Mogreach/SNN_FF-STDP_v1/Gen_out/Saif/README.md

# SAIF 活动文件

保存仿真导出的 Switching Activity Interchange Format 文件，用于 Vivado `report_power` 的动态功耗估计。

- 历史 SAIF 文件：仅用于保留旧功耗分析记录，不用于当前 7010 结果。
- `dut_P8.saif`：并行度配置相关的活动文件。

SAIF 仅在层次路径、顶层、时钟和参数与当前综合网表匹配时有意义。重新跑仿真后，使用 `user/script/gen_saif.tcl` 的层次映射方式重新导入，不应把历史结果当作当前功耗结论。
