Mogreach/SNN_FF-STDP_v1/assets/README.md

# 文档资源

文档图片按文档名称分目录保存。当前全部设计附件位于 `FF-STDP加速器设计（ZYNQ）/`，主文档通过仓库相对路径引用，移动或重命名图片后需同步检查 Markdown 链接。
