Mogreach/SNN_FF-STDP_v1/assets/FF-STDP加速器设计（ZYNQ）/README.md

# FF-STDP 加速器设计图片

本目录统一保存 `FF-STDP加速器设计（ZYNQ）.md` 的历史结构图、Vivado 截图、波形、ILA 截图和时序分析图片。`image N.png` 为旧文档附件名，`Pasted_*.png` 为后续补充图片；为保证引用和历史可追溯性，归档时未批量改名。

新增图片时请继续使用主文档相对路径 `assets/FF-STDP加速器设计（ZYNQ）/<文件名>`，不要引用工作站绝对路径。
