Mogreach/SNN_FF-STDP_v1/user/script/brian2_sim/README.md

# brian2_sim

Brian2 参考模型/验证脚本的预留目录，当前归档没有脚本。现有脉冲编码调用位于 `hardware_sim/gen_data_flow.py`，并依赖仓库外部的 `SNN-forwardforward` 工程。
