Mogreach/SNN_FF-STDP_v1/user/src/snn_ff/synaptic_core/README.md

# 突触与 FF-STDP 更新

- `synaptic_core.v`：读取并行突触权重，形成送往神经元核心的加权输入，并协调训练写回。权重存储由 `SNN_RAM_SIM` 宏二选一：仿真用行为模型，FPGA 用 `sram_synaptic` BRAM IP，详见 `../sram/README.md`。
- `ffstdp_update.v`：根据正/负样本、前后脉冲计数和梯度 ROM 输出计算权重增量，执行定点加法/饱和后写回突触 SRAM。

量化尺度由软件生成脚本中的 `WEIGHT_MAX / 2^(WEIGHT_WIDTH-1)` 决定。修改学习率、权重范围或位宽时，必须联合验证 ROM 数值、补码解释、加法位宽、饱和规则以及权重文件打包顺序。
