Mogreach/SNN_FF-STDP_v1/user/src/snn_ff/aer_out/README.md

# AER 输出

- `aer_out.v`：单路输出事件缓存/握手控制。
- `aer_outs.v`：按并行神经元组织多个输出并汇聚。
- `adder_tree.v`：对并行神经元相关量做树形求和。

该路径把神经元核心产生的脉冲事件编码为 AER 输出，并与下层输入或顶层终端 ack 完成四相握手。修改输出神经元数或并行度时需同步检查 AER 地址宽度 `2+$clog2(OUTPUT_NEURON)`。
