Mogreach/SNN_FF-STDP_v1/assets/FF-STDP加速器设计（ZYNQ）/image 18.png

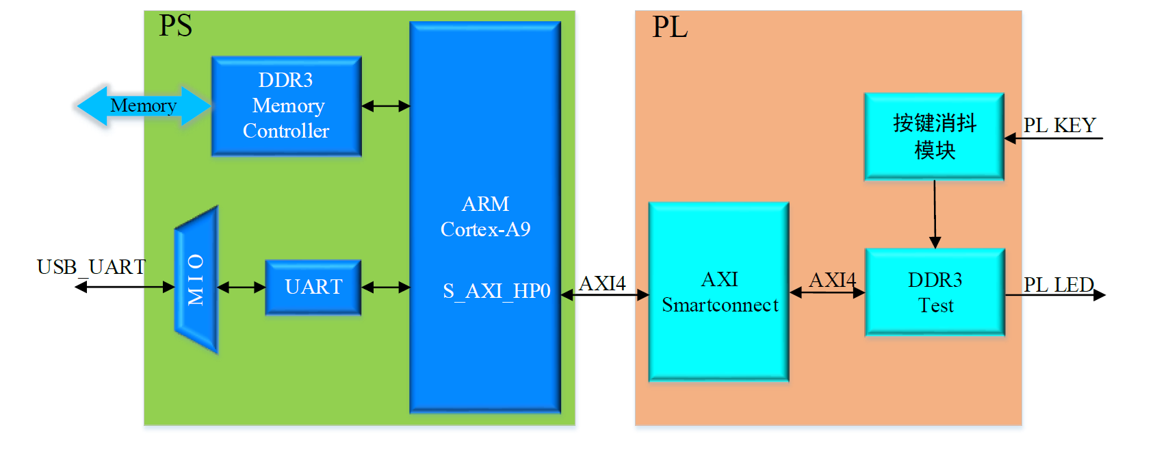
assets/FF-STDP加速器设计（ZYNQ）/image 18.png
