Mogreach/SNN_FF-STDP_v1/assets/FF-STDP加速器设计（ZYNQ）/image.png

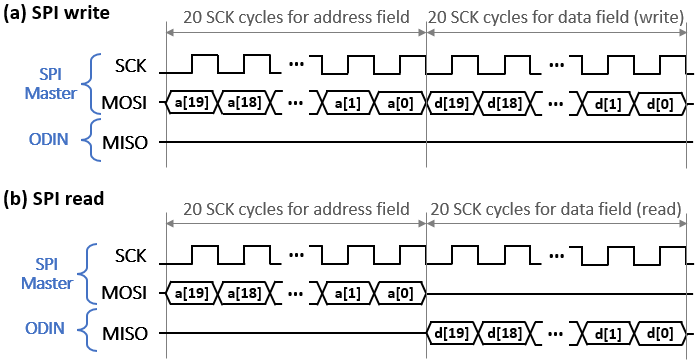
assets/FF-STDP加速器设计（ZYNQ）/image.png
