Mogreach/SNN_FF-STDP_v1/assets/FF-STDP加速器设计（ZYNQ）/Pasted_20260914115012_FF-STDP加速器设计（ZYNQ）.png

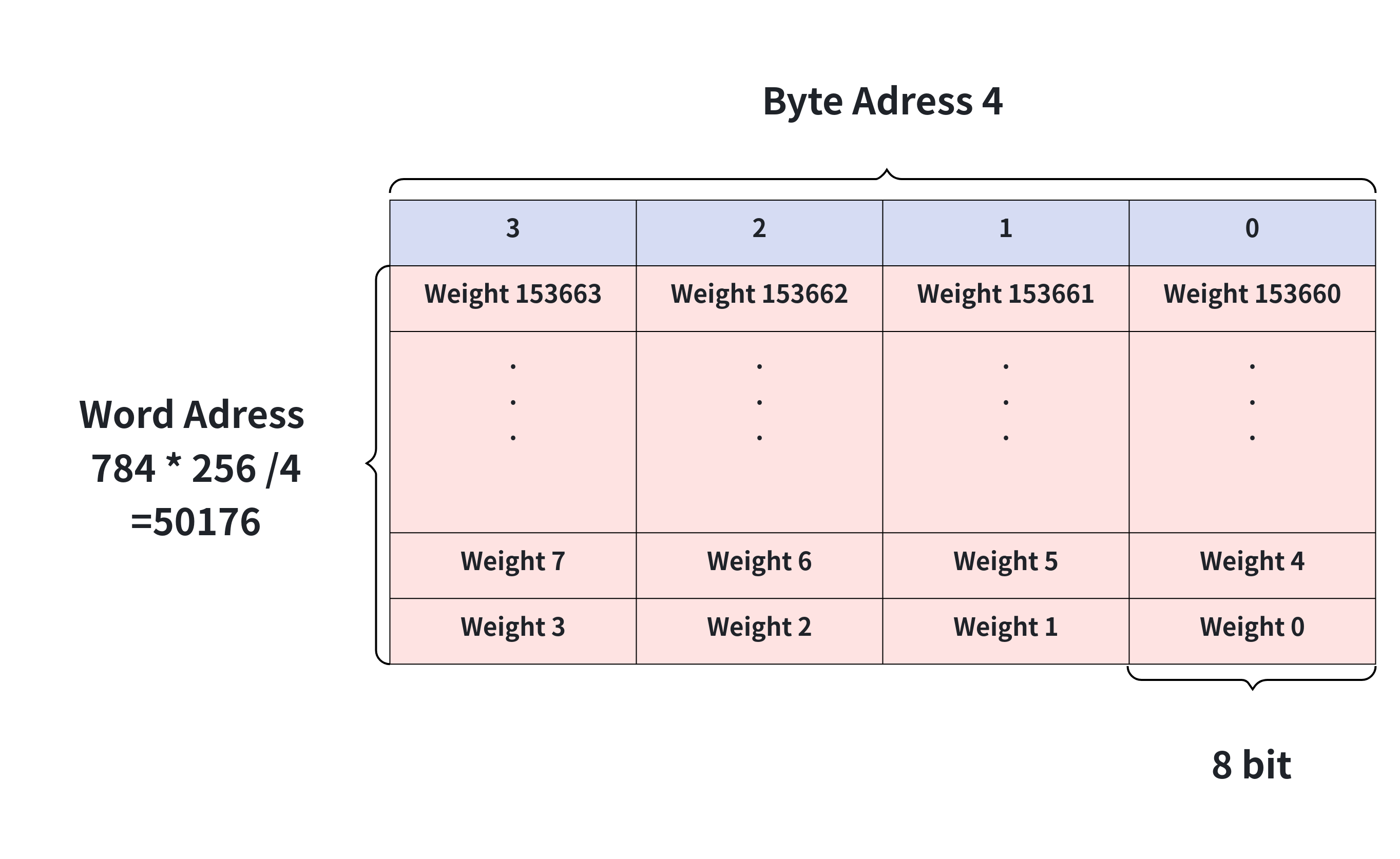
assets/FF-STDP加速器设计（ZYNQ）/Pasted_20260914115012_FF-STDP加速器设计（ZYNQ）.png
