Mogreach/SNN_FF-STDP_v1/user/sim/iverilog/build_axi_test/README.md

# Icarus 构建产物

保存 Icarus Verilog 编译输出、日志和波形。当前 AXI+SNN 回归生成 `tb_axi4_rw_test_v1_0_M_AXI.vvp/.vcd/.log`；这些文件均被 Git 忽略。源文件清单位于上一级 `axi_snn_filelist.f`。
