Mogreach/SNN_FF-STDP_v1/user/data/axi4_ddr_rw.xdc

set_property IOSTANDARD LVCMOS33 [get_ports key_init]
set_property IOSTANDARD LVCMOS33 [get_ports key_train_enable]
set_property IOSTANDARD LVCMOS33 [get_ports train_enable_flag]
set_property IOSTANDARD LVCMOS33 [get_ports train_finish_flag]

set_property PACKAGE_PIN L14 [get_ports key_init]
set_property PACKAGE_PIN K16 [get_ports key_train_enable]
set_property PACKAGE_PIN H15 [get_ports train_enable_flag]
set_property PACKAGE_PIN L15 [get_ports train_finish_flag]
