Mogreach/SNN_FF-STDP_v1/user/src/snn_ff/aer_out/aer_outs.v

// Copyright (C) 2019-2022, Université catholique de Louvain (UCLouvain, Belgium), University of Zürich (UZH, Switzerland),
//         Katholieke Universiteit Leuven (KU Leuven, Belgium), and Delft University of Technology (TU Delft, Netherlands).
// SPDX-License-Identifier: Apache-2.0 WITH SHL-2.1
//
// Licensed under the Solderpad Hardware License v 2.1 (the “License”); you may not use this file except in compliance
// with the License, or, at your option, the Apache License version 2.0. You may obtain a copy of the License at
// https://solderpad.org/licenses/SHL-2.1/
//
// Unless required by applicable law or agreed to in writing, any work distributed under the License is distributed on
// an “AS IS” BASIS, WITHOUT WARRANTIES OR CONDITIONS OF ANY KIND, either express or implied. See the License for the
// specific language governing permissions and limitations under the License.
//
//------------------------------------------------------------------------------
//
// "aer_out.v" - Output AER module, custom monitoring mode from ODIN was removed
// 
// Project: tinyODIN - A low-cost digital spiking neuromorphic processor adapted from ODIN.
//
// Author:  C. Frenkel, Delft University of Technology
//
// Cite/paper: C. Frenkel, M. Lefebvre, J.-D. Legat and D. Bol, "A 0.086-mm² 12.7-pJ/SOP 64k-Synapse 256-Neuron Online-Learning
//             Digital Spiking Neuromorphic Processor in 28-nm CMOS," IEEE Transactions on Biomedical Circuits and Systems,
//             vol. 13, no. 1, pp. 145-158, 2019.
//
//------------------------------------------------------------------------------


module aer_outs #(
    parameter TIME_STEP = 8,
    parameter INPUT_NEURON = 784,
    parameter OUTPUT_NEURON = 256,
    parameter AER_WIDTH = 12,

    parameter PRE_NEUR_ADDR_WIDTH = 10,
    parameter PRE_NEUR_WORD_ADDR_WIDTH= 10,
    parameter PRE_NEUR_BYTE_ADDR_WIDTH = 0,

    parameter POST_NEUR_ADDR_WIDTH = 10,
    parameter POST_NEUR_WORD_ADDR_WIDTH= 8,
    parameter POST_NEUR_BYTE_ADDR_WIDTH = 2,
    parameter POST_NEUR_PARALLEL = 4,
    
    parameter PRE_NEUR_DATA_WIDTH = 8,
    parameter POST_NEUR_DATA_WIDTH = 32,
    parameter POST_NEUR_MEM_WIDTH = 12,
    parameter POST_NEUR_SPIKE_CNT_WIDTH = 7,
    parameter SYN_ARRAY_DATA_WIDTH = 32,
    parameter SYN_ARRAY_ADDR_WIDTH = 16,
    parameter WEIGHT_WIDTH = 8
)(

    // Global input ----------------------------------- 
    input  wire           CLK,
    input  wire           RST,
    // Neuron data inputs -----------------------------
    input  wire [POST_NEUR_PARALLEL-1:0]     NEUR_EVENT_OUT,
    // Input from scheduler ---------------------------
    input  wire [AER_WIDTH-1:0] SCHED_DATA_OUT,
    // Input from controller --------------------------
    input  wire           CTRL_TREF_EVENT,
    input  wire           CTRL_POST_NEUR_CS, 
    input  wire           CTRL_POST_NEUR_WE, 
    input  wire           CTRL_AEROUT_PUSH_NEUR,
    input  wire           CTRL_AEROUT_POP_NEUR,
    input  wire           CTRL_AEROUT_POP_TSTEP,
    input  wire [POST_NEUR_ADDR_WIDTH-1:0]     CTRL_POST_NEURON_ADDRESS,
    input  wire           CTRL_AEROUT_TREF_FINISH,
    // Inputs from neurons ------------------------------------
    input wire [POST_NEUR_SPIKE_CNT_WIDTH * POST_NEUR_PARALLEL -1 :0] POST_NEUR_S_CNT,
    
    // Output to controller ---------------------------
    output wire           AEROUT_CTRL_FINISH,
    
	// Output 8-bit AER link --------------------------
	output reg  [  AER_WIDTH-1:0] AEROUT_ADDR, 
	output reg  	      AEROUT_REQ,
	input  wire 	      AEROUT_ACK,

    output reg [31:0]     GOODNESS,
    output wire           ONE_SAMPLE_FINISH
);
    localparam T_LOG2 = $clog2(TIME_STEP);
    reg                                 AEROUT_ACK_sync_int,      AEROUT_ACK_sync,AEROUT_ACK_sync_del;
    reg                                 aer_out_addr_last,        aer_out_addr_last_int;
    reg                                 aer_out_trans               ;//AEROUT输出事件中
    reg                                 fifo_rd_en_int              ;
    reg                                 goodness_en_d0              ;
    reg                                 goodness_en_d1              ;
    reg                [   5: 0]        ctrl_tref_finish_delay      ;

    wire                                aer_out_start               ;
    wire                                AEROUT_ACK_sync_negedge     ;
    wire                                aer_out_addr_last_negedge   ;
    wire                                rst_activity                ;
    wire                                fifo_rd_en                  ;
    wire                                fifo_wr_en                  ;
    wire                                fifo_empty                  ;
    wire                                fifo_full                   ;
    wire                                goodness_en                 ;
    wire                                ctrl_tref_finish_delay_posedge  ;
    
    
    
    wire               [POST_NEUR_PARALLEL*AER_WIDTH-1: 0]                  aer_out_fifo_din                 ;
    wire               [AER_WIDTH-1: 0]                                     aer_out_fifo_dout                ;
    wire               [    T_LOG2: 0]                                      post_neur_cnt[0:POST_NEUR_PARALLEL-1];
    reg                [2*(T_LOG2+1)-1: 0]                                  post_neur_goodness[0:POST_NEUR_PARALLEL-1];
    wire               [(2*(T_LOG2+1)*POST_NEUR_PARALLEL)-1: 0]             post_neur_goodness_bus;
    wire [2*(T_LOG2+1)+$clog2(POST_NEUR_PARALLEL)-1:0] post_neur_goodness_sum;

    assign                              rst_activity                = RST;
    // AER空闲，fifo不空，且此时fifo_out不是无效事件
    assign                              fifo_rd_en                  = CTRL_AEROUT_POP_NEUR & !AEROUT_REQ & !AEROUT_ACK_sync & !fifo_empty & !aer_out_start;
    assign                              fifo_wr_en                  = CTRL_AEROUT_PUSH_NEUR & !fifo_full;

    assign                              AEROUT_ACK_sync_negedge     = !AEROUT_ACK_sync & AEROUT_ACK_sync_del;
    assign                              aer_out_addr_last_negedge   = !aer_out_addr_last & aer_out_addr_last_int;

    assign                              aer_out_start               = fifo_rd_en_int && (!(&aer_out_fifo_dout[11:10]));// 无效事件11则不传输
    assign                              AEROUT_CTRL_FINISH          = aer_out_addr_last_negedge;

    assign                              ctrl_tref_finish_delay_posedge= !ctrl_tref_finish_delay[5] && ctrl_tref_finish_delay[4];
    assign                              ONE_SAMPLE_FINISH           = ctrl_tref_finish_delay_posedge;
    assign                              goodness_en                 = CTRL_POST_NEUR_WE && CTRL_TREF_EVENT;
    

    genvar i;
    generate
        for (i = 0; i<POST_NEUR_PARALLEL; i=i+1) begin : gen_aer_output_lane
            localparam [POST_NEUR_ADDR_WIDTH-1:0] LANE_OFFSET = i;
            wire [POST_NEUR_ADDR_WIDTH-1:0] lane_neuron_addr;
            assign lane_neuron_addr = CTRL_POST_NEURON_ADDRESS + LANE_OFFSET;
            assign post_neur_cnt[i] = POST_NEUR_S_CNT[i*POST_NEUR_SPIKE_CNT_WIDTH +: T_LOG2+1];
            assign aer_out_fifo_din[AER_WIDTH*(POST_NEUR_PARALLEL-i)-1 -: AER_WIDTH] =
                NEUR_EVENT_OUT[i] ? {2'b00, lane_neuron_addr} : {2'b11, 10'd0};
            // goodness_mult goodness_square (
            // .CLK                                (CLK                       ),// input wire CLK
            // .A                                  (post_neur_cnt[i]          ),// input wire [4 : 0] A
            // .B                                  (post_neur_cnt[i]          ),// input wire [4 : 0] B
            // .P                                  (post_neur_goodness[i]     ) // output wire [9 : 0] P
            //         );
            always @(posedge CLK)           
            begin                                        
                post_neur_goodness[i] <= post_neur_cnt[i] * post_neur_cnt[i];              
            end

            assign post_neur_goodness_bus[i*(2*(T_LOG2+1))+:2*(T_LOG2+1)] = post_neur_goodness[i];
        end
    endgenerate


    adder_tree #(
        .N(POST_NEUR_PARALLEL),
        .WIDTH(2*(T_LOG2+1))
    ) adder_tree_goodness (
        .in(post_neur_goodness_bus),
        .out(post_neur_goodness_sum)
    );

    always @(posedge CLK or posedge rst_activity)           
        begin                                        
            if(rst_activity || ctrl_tref_finish_delay_posedge)                               
                GOODNESS <= 'd0;                         
            else if(goodness_en_d1)                                
                GOODNESS <= GOODNESS + post_neur_goodness_sum;              
            else   
                GOODNESS <= GOODNESS;                                  
        end                                          


    // Sync barrier
    always @(posedge CLK, posedge rst_activity) begin
        if (rst_activity) begin
            AEROUT_ACK_sync_int <= 1'b0;
            AEROUT_ACK_sync	    <= 1'b0;
            AEROUT_ACK_sync_del <= 1'b0;
            aer_out_addr_last_int <= 1'b0;
            fifo_rd_en_int <= 1'b0;
            goodness_en_d0 <= 1'b0;
            goodness_en_d1 <= 1'b0;
            ctrl_tref_finish_delay <= 6'b0;
        end
        else begin
            AEROUT_ACK_sync_int <= AEROUT_ACK;
            AEROUT_ACK_sync	    <= AEROUT_ACK_sync_int;
            AEROUT_ACK_sync_del <= AEROUT_ACK_sync;
            aer_out_addr_last_int <= aer_out_addr_last;
            fifo_rd_en_int <= fifo_rd_en;
            goodness_en_d0 <= goodness_en;
            goodness_en_d1 <= goodness_en_d0;
            ctrl_tref_finish_delay <= {ctrl_tref_finish_delay[4:0],CTRL_AEROUT_TREF_FINISH};
        end
    end

                                                                            
    // Output AER interface
    always @(posedge CLK, posedge rst_activity) begin
        if (rst_activity) begin
            AEROUT_ADDR             <= 10'b0;
            AEROUT_REQ              <= 1'b0;
            aer_out_trans           <= 1'b0;
            aer_out_addr_last       <= 1'b0;
        end else begin
            // 只有当处于POP_TSTEP，且fifo已排空，且aerout不在传输中，且还没发送tstep_event，才开始发送tstep_event
            if (CTRL_AEROUT_POP_TSTEP && fifo_empty && !aer_out_trans && !AEROUT_CTRL_FINISH)begin
                AEROUT_ADDR      <= {2'b01,10'd0};
                AEROUT_REQ       <= 1'b1;
                aer_out_trans    <= 1'b1;
                aer_out_addr_last <= 1'b1;
            end else if ((aer_out_start) && !AEROUT_ACK_sync) begin
                AEROUT_ADDR      <= aer_out_fifo_dout;
                AEROUT_REQ       <= 1'b1;
                aer_out_trans <= 1'b1;
                aer_out_addr_last <= 1'b0;
            end else if (AEROUT_ACK_sync) begin
                AEROUT_REQ       <= 1'b0;
                aer_out_trans <= 1'b1;
                aer_out_addr_last <= aer_out_addr_last;
            end else if (AEROUT_ACK_sync_negedge) begin
                AEROUT_REQ       <= 1'b0;
                aer_out_trans <= 1'b0;
                aer_out_addr_last <= 1'b0;
            end
        end
    end
    
    // aer_out_fifo aer_out_fifo_0 (
    // .clk(CLK),      // input wire clk
    // .srst(rst_activity),    // input wire srst
    // .din(aer_out_fifo_din),      // input wire [47 : 0] din
    // .wr_en(fifo_wr_en),  // input wire wr_en
    // .rd_en(fifo_rd_en),  // input wire rd_en
    // .dout(aer_out_fifo_dout),    // output wire [11 : 0] dout
    // .full(fifo_full),    // output wire full
    // .empty(fifo_empty)  // output wire empty
    // );
    
    syncFIFO_diffWidth #(
    .DIN_WIDTH                             (AER_WIDTH * POST_NEUR_PARALLEL),
    .DOUT_WIDTH                            (AER_WIDTH          ),
    .WADDR_WIDTH                           ($clog2(2*(POST_NEUR_PARALLEL-1))) 
    ) syncFIFO_diffWidth_u0 (
    .din                                   (aer_out_fifo_din   ),
    .wr_en                                 (fifo_wr_en         ),
    .full                                  (fifo_full          ),
    .almost_full                           (                   ),
    .dout                                  (aer_out_fifo_dout  ),
    .rd_en                                 (fifo_rd_en         ),
    .empty                                 (fifo_empty         ),
    .almost_empty                          (                   ),
    .clk                                   (CLK                ),
    .rst                                   (RST                ) 
    );

endmodule 
