Mogreach/SNN_FF-STDP_v1/user/src/snn_ff/sram/sram_synaptic.v

// 仿真用行为模型。FPGA 构建由工程中的 blk_mem_gen IP "sram_synaptic" 提供，
// 二者模块名相同，因此本文件整体只在定义了 SNN_RAM_SIM 时参与编译，
// 避免把整个 user/src 加入 Vivado 时产生重复定义。
`ifdef SNN_RAM_SIM
module sram_synaptic #(
    parameter  ADDR_WIDTH = 8,
    parameter  DATA_WIDTH = 32,
    parameter  SRAM_DEPTH = 256
)

(

    // Global inputs
    input          CK,                       // Clock (synchronous read/write)

    // Control and data inputs
    input          CS,                       // Chip select
    input          WE,                       // Write enable
    input  [ADDR_WIDTH-1:0] A,                        // Address bus 
    input  [DATA_WIDTH-1:0] D,                        // Data input bus (write)

    // Data output
    output [DATA_WIDTH-1:0] Q                         // Data output bus (read)   
);
    /*
     *  Simple behavioral code for simulation, to be replaced by a 256-word 32-bit SRAM macro 
     *  or Block RAM (BRAM) memory with the same format for FPGA implementations.
     */      
        reg [DATA_WIDTH-1:0] SRAM[0:SRAM_DEPTH-1];
        reg [DATA_WIDTH-1:0] Qr;

        always @(posedge CK) begin
            Qr <= CS ? SRAM[A] : Qr;
            if (CS & WE) SRAM[A] <= D;
        end
        assign Q = Qr;


endmodule
`endif
