Mogreach/SNN_FF-STDP_v1/user/src/axi_rw/axi4_rw_test_v1_0_M_AXI.v

`timescale 1 ns / 1 ps

	module axi4_rw_test_v1_0_M_AXI #
	(
		// Users to add parameters here
		parameter TIME_TOTAL_STEP = 8,
		parameter DATA_SIZE = 784,
		parameter TOTAL_TRAIN_SIZE = 2 * 1000, // 训练样本数（含正负样本）
		parameter TOTAL_TEST_SIZE  = 10 * 100, //  测试样本数
		// User parameters ends

		// Do not modify the parameters beyond this line
		// Base address of targeted slave
		parameter  C_M_TARGET_SLAVE_READ_ADDR	= 32'h00200000, // 读基地址
		parameter  C_M_TARGET_SLAVE_WRITE_ADDR  = 32'h01900000, // 写基地址
		// Burst Length. Supports 1, 2, 4, 8, 16, 32, 64, 128, 256 burst lengths
		//每次突发传输的长度（以数据字为单位）。
		parameter integer C_M_AXI_READ_BURST_LEN	= 4,
		parameter integer C_M_AXI_WRITE_BURST_LEN	= 1,
		// Thread ID Width
		parameter integer C_M_AXI_ID_WIDTH	= 1,
		// Width of Address Bus
		parameter integer C_M_AXI_ADDR_WIDTH	= 32,
		// Width of Data Bus
		//数据总线的宽度（以位为单位）。
		parameter integer C_M_AXI_DATA_WIDTH	= 32,
		// Width of User Write Address Bus
		parameter integer C_M_AXI_AWUSER_WIDTH	= 0,
		// Width of User Read Address Bus
		parameter integer C_M_AXI_ARUSER_WIDTH	= 0,
		// Width of User Write Data Bus
		parameter integer C_M_AXI_WUSER_WIDTH	= 0,
		// Width of User Read Data Bus
		parameter integer C_M_AXI_RUSER_WIDTH	= 0,
		// Width of User Response Bus
		parameter integer C_M_AXI_BUSER_WIDTH	= 0
	)
	(
		// Users to add ports here
		// input from SNN Module
		input  wire                         PROCESS_DONE               ,
		input  wire        [  31: 0]        GOODNESS                   ,
		input  wire                         SNN_CLK                    ,
		input  wire                         AER_IN_ACK                 ,
		output wire                         AER_IN_REQ                 ,
		output wire        [  11: 0]        AER_IN_ADDR                ,
    	output reg                          IS_POS                     ,
		output reg   						IS_TRAIN                   ,
		input wire  train_enable_txn,
		// Debug
    	output wire        [   2: 0]        STATE                      ,
		// User ports ends

		// Do not modify the ports beyond this line
		// Initiate AXI transactions
		input wire  INIT_AXI_TXN,
		// Asserts when transaction is complete
		output reg  TRAIN_ENABLE_FLAG,
		// Asserts when ERROR is detected
		output reg  TRAIN_FINISH_FLAG,
		// Global Clock Signal.
		input wire  M_AXI_ACLK,
		// Global Reset Singal. This Signal is Active Low
		input wire  M_AXI_ARESETN,
		// Master Interface Write Address ID
		output wire [C_M_AXI_ID_WIDTH-1 : 0] M_AXI_AWID,
		// Master Interface Write Address
		output wire [C_M_AXI_ADDR_WIDTH-1 : 0] M_AXI_AWADDR,
		// Burst length. The burst length gives the exact number of transfers in a burst
		output wire [7 : 0] M_AXI_AWLEN,
		// Burst size. This signal indicates the size of each transfer in the burst
		output wire [2 : 0] M_AXI_AWSIZE,
		// Burst type. The burst type and the size information, 
    // determine how the address for each transfer within the burst is calculated.
		output wire [1 : 0] M_AXI_AWBURST,
		// Lock type. Provides additional information about the
    // atomic characteristics of the transfer.
		output wire  M_AXI_AWLOCK,
		// Memory type. This signal indicates how transactions
    // are required to progress through a system.
		output wire [3 : 0] M_AXI_AWCACHE,
		// Protection type. This signal indicates the privilege
    // and security level of the transaction, and whether
    // the transaction is a data access or an instruction access.
		output wire [2 : 0] M_AXI_AWPROT,
		// Quality of Service, QoS identifier sent for each write transaction.
		output wire [3 : 0] M_AXI_AWQOS,
		// Optional User-defined signal in the write address channel.
		output wire [C_M_AXI_AWUSER_WIDTH-1 : 0] M_AXI_AWUSER,
		// Write address valid. This signal indicates that
    // the channel is signaling valid write address and control information.
		output wire  M_AXI_AWVALID,
		// Write address ready. This signal indicates that
    // the slave is ready to accept an address and associated control signals
		input wire  M_AXI_AWREADY,
		// Master Interface Write Data.
		output wire [C_M_AXI_DATA_WIDTH-1 : 0] M_AXI_WDATA,
		// Write strobes. This signal indicates which byte
    // lanes hold valid data. There is one write strobe
    // bit for each eight bits of the write data bus.
		output wire [C_M_AXI_DATA_WIDTH/8-1 : 0] M_AXI_WSTRB,
		// Write last. This signal indicates the last transfer in a write burst.
		output wire  M_AXI_WLAST,
		// Optional User-defined signal in the write data channel.
		output wire [C_M_AXI_WUSER_WIDTH-1 : 0] M_AXI_WUSER,
		// Write valid. This signal indicates that valid write
    // data and strobes are available
		output wire  M_AXI_WVALID,
		// Write ready. This signal indicates that the slave
    // can accept the write data.
		input wire  M_AXI_WREADY,
		// Master Interface Write Response.
		input wire [C_M_AXI_ID_WIDTH-1 : 0] M_AXI_BID,
		// Write response. This signal indicates the status of the write transaction.
		input wire [1 : 0] M_AXI_BRESP,
		// Optional User-defined signal in the write response channel
		input wire [C_M_AXI_BUSER_WIDTH-1 : 0] M_AXI_BUSER,
		// Write response valid. This signal indicates that the
    // channel is signaling a valid write response.
		input wire  M_AXI_BVALID,
		// Response ready. This signal indicates that the master
    // can accept a write response.
		output wire  M_AXI_BREADY,
		// Master Interface Read Address.
		output wire [C_M_AXI_ID_WIDTH-1 : 0] M_AXI_ARID,
		// Read address. This signal indicates the initial
    // address of a read burst transaction.
		output wire [C_M_AXI_ADDR_WIDTH-1 : 0] M_AXI_ARADDR,
		// Burst length. The burst length gives the exact number of transfers in a burst
		output wire [7 : 0] M_AXI_ARLEN,
		// Burst size. This signal indicates the size of each transfer in the burst
		output wire [2 : 0] M_AXI_ARSIZE,
		// Burst type. The burst type and the size information, 
    // determine how the address for each transfer within the burst is calculated.
		output wire [1 : 0] M_AXI_ARBURST,
		// Lock type. Provides additional information about the
    // atomic characteristics of the transfer.
		output wire  M_AXI_ARLOCK,
		// Memory type. This signal indicates how transactions
    // are required to progress through a system.
		output wire [3 : 0] M_AXI_ARCACHE,
		// Protection type. This signal indicates the privilege
    // and security level of the transaction, and whether
    // the transaction is a data access or an instruction access.
		output wire [2 : 0] M_AXI_ARPROT,
		// Quality of Service, QoS identifier sent for each read transaction
		output wire [3 : 0] M_AXI_ARQOS,
		// Optional User-defined signal in the read address channel.
		output wire [C_M_AXI_ARUSER_WIDTH-1 : 0] M_AXI_ARUSER,
		// Write address valid. This signal indicates that
    // the channel is signaling valid read address and control information
		output wire  M_AXI_ARVALID,
		// Read address ready. This signal indicates that
    // the slave is ready to accept an address and associated control signals
		input wire  M_AXI_ARREADY,
		// Read ID tag. This signal is the identification tag
    // for the read data group of signals generated by the slave.
		input wire [C_M_AXI_ID_WIDTH-1 : 0] M_AXI_RID,
		// Master Read Data
		input wire [C_M_AXI_DATA_WIDTH-1 : 0] M_AXI_RDATA,
		// Read response. This signal indicates the status of the read transfer
		input wire [1 : 0] M_AXI_RRESP,
		// Read last. This signal indicates the last transfer in a read burst
		input wire  M_AXI_RLAST,
		// Optional User-defined signal in the read address channel.
		input wire [C_M_AXI_RUSER_WIDTH-1 : 0] M_AXI_RUSER,
		// Read valid. This signal indicates that the channel
    // is signaling the required read data.
		input wire  M_AXI_RVALID,
		// Read ready. This signal indicates that the master can
    // accept the read data and response information.
		output wire  M_AXI_RREADY
	);


	// function called clogb2 that returns an integer which has the
	//value of the ceiling of the log base 2

	  // function called clogb2 that returns an integer which has the 
	  // value of the ceiling of the log base 2.                      
	  function integer clogb2 (input integer bit_depth);              
	  begin                                                           
	    for(clogb2=0; bit_depth>0; clogb2=clogb2+1)                   
	      bit_depth = bit_depth >> 1;                                 
	    end                                                           
	  endfunction                                                     

	// C_TRANSACTIONS_NUM is the width of the index counter for 
	// number of write or read transaction.
	 localparam integer C_TRANSACTIONS_NUM = clogb2(C_M_AXI_READ_BURST_LEN-1);

	// Burst length for transactions, in C_M_AXI_DATA_WIDTHs.
	// Non-2^n lengths will eventually cause bursts across 4K address boundaries.
	 localparam integer C_MASTER_LENGTH	= 12;
	// total number of burst transfers is master length divided by burst length and burst size
	 localparam integer C_NO_BURSTS_REQ = C_MASTER_LENGTH-clogb2((C_M_AXI_READ_BURST_LEN*C_M_AXI_DATA_WIDTH/8)-1);
	 localparam integer SIZE_OF_SAMPLE = TIME_TOTAL_STEP * DATA_SIZE;
	 //注意需要能够被整除，不然可能会出错
	 localparam integer ONE_SAMPLE_READ_BURST_COUNT = (SIZE_OF_SAMPLE/8) / (C_M_AXI_READ_BURST_LEN * C_M_AXI_DATA_WIDTH/8);
	 localparam integer ONE_SAMPLE_WRITE_BURST_COUNT = 1;
	// Example State machine to initialize counter, initialize write transactions, 
	// initialize read transactions and comparison of read data with the 
	// written data words.
	parameter [2:0] 
		INIT = 3'b000,
		IDLE = 3'b001, // This state initiates AXI4Lite transaction 
			// after the state machine changes state to READ_DATA
			// when there is 0 to 1 transition on INIT_AXI_TXN
		READ_DATA = 3'b010, // This state initializes read transaction
		PROCESS_DATA = 3'b011, // 新增状态
			// once reads are done, the state machine 
			// changes state to PROCESS_DATA 
		WRITE_DATA   = 3'b100, // This state initializes write transaction,
			// once writes are done, the state machine 
			// changes state to READ_DATA 
		DONE = 3'b101, // This state issues the status of comparison of the written data with the read data
		NEXT_SAMPLE = 3'b110;

	 reg [2:0] mst_exec_state;
	 reg [2:0] mst_exec_state_next;
	 assign STATE = mst_exec_state;

	// AXI4LITE signals
	//AXI4 internal temp signals
	reg [C_M_AXI_ADDR_WIDTH-1 : 0] 	axi_awaddr;
	reg  	axi_awvalid;
	reg [C_M_AXI_DATA_WIDTH-1 : 0] 	axi_wdata;
	reg  	axi_wlast;
	reg  	axi_wvalid;
	reg  	axi_bready;
	reg [C_M_AXI_ADDR_WIDTH-1 : 0] 	axi_araddr;
	reg  	axi_arvalid;
	reg  	axi_rready;
	//write beat count in a burst
	reg [C_TRANSACTIONS_NUM : 0] 	write_index;
	//read beat count in a burst
	reg [C_TRANSACTIONS_NUM : 0] 	read_index;
	//size of C_M_AXI_READ_BURST_LEN length burst in bytes
	wire [C_TRANSACTIONS_NUM+2 : 0] read_burst_size_bytes;
	wire [C_TRANSACTIONS_NUM+2 : 0] write_burst_size_bytes;
	//The burst counters are used to track the number of burst transfers of C_M_AXI_READ_BURST_LEN burst length needed to transfer 2^C_MASTER_LENGTH bytes of data.
	reg [C_NO_BURSTS_REQ : 0] 	write_burst_counter;
	reg [C_NO_BURSTS_REQ : 0] 	read_burst_counter;
	reg  	start_single_burst_write;
	reg  	start_single_burst_read;
	reg  	writes_done;
	reg  	reads_done;
	reg  	train_finish_reg;
	reg  	read_mismatch;
	reg  	burst_write_active;
	reg  	burst_read_active;
	reg [C_M_AXI_DATA_WIDTH-1 : 0] 	expected_rdata;
	//Interface response error flags
	wire  	write_resp_error;
	wire  	read_resp_error;
	wire  	wnext;
	wire  	rnext;
	reg  	init_txn_ff;
	reg  	init_txn_ff2;
	wire  	init_txn_pulse;
	reg  	train_enable_txn_ff;
	reg  	train_enable_txn_ff2;
	wire  	train_enable_txn_pulse;

	//用户自定义信号
    reg                [  20: 0]        sample_count                ;
    wire                                input_fifo_full             ;
    wire                                input_fifo_empty            ;
    wire               [   3: 0]        input_fifo_rd_out           ;
    wire                                pts_ready                   ;
    wire                                finish                      ;
    reg                                 spike_data_vaild            ;
    reg                                 input_fifo_rd_en            ;

    reg                [   1: 0]        PROCESS_DONE_reg            ;
    reg                [  31: 0]        GOODNESS_reg                ;
    wire                                PROCESS_DONE_reg_negedge    ;
    wire               [  31: 0]        M_AXI_RDATA_REVERSED        ;
	// I/O Connections assignments
	//I/O Connections. Write Address (AW)
	assign M_AXI_AWID	= 'b0;
	//The AXI address is a concatenation of the target base address + active offset range
	assign M_AXI_AWADDR	= C_M_TARGET_SLAVE_WRITE_ADDR + axi_awaddr;
	//Burst LENgth is number of transaction beats, minus 1
	assign M_AXI_AWLEN	= C_M_AXI_WRITE_BURST_LEN - 1;
	//Size should be C_M_AXI_DATA_WIDTH, in 2^SIZE bytes, otherwise narrow bursts are used
	assign M_AXI_AWSIZE	= clogb2((C_M_AXI_DATA_WIDTH/8)-1);
	//INCR burst type is usually used, except for keyhole bursts
	assign M_AXI_AWBURST	= 2'b01;
	assign M_AXI_AWLOCK	= 1'b0;
	//Update value to 4'b0011 if coherent accesses to be used via the Zynq ACP port. Not Allocated, Modifiable, not Bufferable. Not Bufferable since this example is meant to test memory, not intermediate cache. 
	assign M_AXI_AWCACHE	= 4'b0010;
	assign M_AXI_AWPROT	= 3'h0;
	assign M_AXI_AWQOS	= 4'h0;
	assign M_AXI_AWUSER	= 'b1;
	assign M_AXI_AWVALID	= axi_awvalid;
	//Write Data(W)
	assign M_AXI_WDATA	= axi_wdata;
	//All bursts are complete and aligned in this example
	assign M_AXI_WSTRB	= {(C_M_AXI_DATA_WIDTH/8){1'b1}};
	assign M_AXI_WLAST	= axi_wlast;
	assign M_AXI_WUSER	= 'b0;
	assign M_AXI_WVALID	= axi_wvalid;
	//Write Response (B)
	assign M_AXI_BREADY	= axi_bready;
	//Read Address (AR)
	assign M_AXI_ARID	= 'b0;
	assign M_AXI_ARADDR	= C_M_TARGET_SLAVE_READ_ADDR + axi_araddr;
	//Burst LENgth is number of transaction beats, minus 1
	assign M_AXI_ARLEN	= C_M_AXI_READ_BURST_LEN - 1;
	//Size should be C_M_AXI_DATA_WIDTH, in 2^n bytes, otherwise narrow bursts are used
	assign M_AXI_ARSIZE	= clogb2((C_M_AXI_DATA_WIDTH/8)-1);
	//INCR burst type is usually used, except for keyhole bursts
	assign M_AXI_ARBURST	= 2'b01;
	assign M_AXI_ARLOCK	= 1'b0;
	//Update value to 4'b0011 if coherent accesses to be used via the Zynq ACP port. Not Allocated, Modifiable, not Bufferable. Not Bufferable since this example is meant to test memory, not intermediate cache. 
	assign M_AXI_ARCACHE	= 4'b0010;
	assign M_AXI_ARPROT	= 3'h0;
	assign M_AXI_ARQOS	= 4'h0;
	assign M_AXI_ARUSER	= 'b1;
	assign M_AXI_ARVALID	= axi_arvalid;
	//Read and Read Response (R)
	assign M_AXI_RREADY	= axi_rready;
	//Example design I/O
	//Burst size in bytes
	assign read_burst_size_bytes	= C_M_AXI_READ_BURST_LEN * C_M_AXI_DATA_WIDTH/8;
	assign write_burst_size_bytes	= C_M_AXI_WRITE_BURST_LEN * C_M_AXI_DATA_WIDTH/8;
	assign init_txn_pulse	= (!init_txn_ff2) && init_txn_ff;
	assign train_enable_txn_pulse	= (!train_enable_txn_ff2) && train_enable_txn_ff;

	
	assign  PROCESS_DONE_reg_negedge = PROCESS_DONE_reg[1] && (~PROCESS_DONE_reg[0]);        


	//Generate a pulse to initiate AXI transaction.
	always @(posedge M_AXI_ACLK)										      
	  begin                                                                        
	    // Initiates AXI transaction delay    
	    if (M_AXI_ARESETN == 0 )                                                   
	      begin                                                                    
	        init_txn_ff <= 1'b0;                                                   
	        init_txn_ff2 <= 1'b0;
			train_enable_txn_ff <= 1'b0;                                                   
	        train_enable_txn_ff2 <= 1'b0;                                                      
	      end                                                                               
	    else                                                                       
	      begin  
	        init_txn_ff <= INIT_AXI_TXN;
	        init_txn_ff2 <= init_txn_ff;
			train_enable_txn_ff <= train_enable_txn;
	        train_enable_txn_ff2 <= train_enable_txn_ff;                                                                  
	      end                                                                      
	  end   
	
	//--------------------
	//Write Address Channel
	//--------------------

	// The purpose of the write address channel is to request the address and 
	// command information for the entire transaction.  It is a single beat
	// of information.

	// The AXI4 Write address channel in this example will continue to initiate
	// write commands as fast as it is allowed by the slave/interconnect.
	// The address will be incremented on each accepted address transaction,
	// by burst_size_byte to point to the next address. 

	  always @(posedge M_AXI_ACLK)                                   
	  begin                                                                
	                                                                       
	    if (M_AXI_ARESETN == 0 || init_txn_pulse == 1'b1 )                                           
	      begin                                                            
	        axi_awvalid <= 1'b0;                                           
	      end                                                              
	    // If previously not valid , start next transaction                
	    else if (~axi_awvalid && start_single_burst_write)                 
	      begin                                                            
	        axi_awvalid <= 1'b1;                                           
	      end                                                              
	    /* Once asserted, VALIDs cannot be deasserted, so axi_awvalid      
	    must wait until transaction is accepted */                         
	    else if (M_AXI_AWREADY && axi_awvalid)                             
	      begin                                                            
	        axi_awvalid <= 1'b0;                                           
	      end                                                              
	    else                                                               
	      axi_awvalid <= axi_awvalid;                                      
	    end                                                                
	                                                                       
	                                                                       
	// Next address after AWREADY indicates previous address acceptance    
	  always @(posedge M_AXI_ACLK)                                         
	  begin                                                                
	    if (M_AXI_ARESETN == 0 || init_txn_pulse == 1'b1)                                            
	      begin                                                            
	        axi_awaddr <= 'b0;                                             
	      end                                                              
	    else if (M_AXI_AWREADY && axi_awvalid)                             
	      begin                                                            
	        axi_awaddr <= axi_awaddr + write_burst_size_bytes;                   
	      end                                                              
	    else                                                               
	      axi_awaddr <= axi_awaddr;                                        
	    end                                                                
	//--------------------
	//Write Data Channel
	//--------------------

	//The write data will continually try to push write data across the interface.

	//The amount of data accepted will depend on the AXI slave and the AXI
	//Interconnect settings, such as if there are FIFOs enabled in interconnect.

	//Note that there is no explicit timing relationship to the write address channel.
	//The write channel has its own throttling flag, separate from the AW channel.

	//Synchronization between the channels must be determined by the user.

	//The simpliest but lowest performance would be to only issue one address write
	//and write data burst at a time.

	//In this example they are kept in sync by using the same address increment
	//and burst sizes. Then the AW and W channels have their transactions measured
	//with threshold counters as part of the user logic, to make sure neither 
	//channel gets too far ahead of each other.

	//Forward movement occurs when the write channel is valid and ready

	  assign wnext = M_AXI_WREADY & axi_wvalid;                                   
	                                                                                    
	// WVALID logic, similar to the axi_awvalid always block above                      
	  always @(posedge M_AXI_ACLK)                                                      
	  begin                                                                             
	    if (M_AXI_ARESETN == 0 || init_txn_pulse == 1'b1 )                                                        
	      begin                                                                         
	        axi_wvalid <= 1'b0;                                                         
	      end                                                                           
	    // If previously not valid, start next transaction                              
	    else if (~axi_wvalid && start_single_burst_write)                               
	      begin                                                                         
	        axi_wvalid <= 1'b1;                                                         
	      end                                                                           
	    /* If WREADY and too many writes, throttle WVALID                               
	    Once asserted, VALIDs cannot be deasserted, so WVALID                           
	    must wait until burst is complete with WLAST */                                 
	    else if (wnext && axi_wlast)                                                    
	      axi_wvalid <= 1'b0;                                                           
	    else                                                                            
	      axi_wvalid <= axi_wvalid;                                                     
	  end                                                                               
	                                                                                    
	                                                                                    
	//WLAST generation on the MSB of a counter underflow                                
	// WVALID logic, similar to the axi_awvalid always block above                      
	  always @(posedge M_AXI_ACLK)                                                      
	  begin                                                                             
	    if (M_AXI_ARESETN == 0 || init_txn_pulse == 1'b1 )                                                        
	      begin                                                                         
	        axi_wlast <= 1'b0;                                                          
	      end                                                                           
	    // axi_wlast is asserted when the write index                                   
	    // count reaches the penultimate count to synchronize                           
	    // with the last write data when write_index is b1111                           
	    // else if (&(write_index[C_TRANSACTIONS_NUM-1:1])&& ~write_index[0] && wnext)  
	    else if (((write_index == C_M_AXI_WRITE_BURST_LEN-2 && C_M_AXI_WRITE_BURST_LEN >= 2) && wnext) || (C_M_AXI_WRITE_BURST_LEN == 1 ))
	      begin                                                                         
	        axi_wlast <= 1'b1;                                                          
	      end                                                                           
	    // Deassrt axi_wlast when the last write data has been                          
	    // accepted by the slave with a valid response                                  
	    else if (wnext)                                                                 
	      axi_wlast <= 1'b0;                                                            
	    else if (axi_wlast && C_M_AXI_WRITE_BURST_LEN == 1)                                   
	      axi_wlast <= 1'b0;                                                            
	    else                                                                            
	      axi_wlast <= axi_wlast;                                                       
	  end                                                                               
	                                                                                    
	                                                                                    
	/* Burst length counter. Uses extra counter register bit to indicate terminal       
	 count to reduce decode logic */                                                    
	  always @(posedge M_AXI_ACLK)                                                      
	  begin                                                                             
	    if (M_AXI_ARESETN == 0 || init_txn_pulse == 1'b1 || start_single_burst_write == 1'b1)    
	      begin                                                                         
	        write_index <= 0;                                                           
	      end                                                                           
	    else if (wnext && (write_index != C_M_AXI_WRITE_BURST_LEN-1))                         
	      begin                                                                         
	        write_index <= write_index + 1;                                             
	      end                                                                           
	    else                                                                            
	      write_index <= write_index;                                                   
	  end                                                                               
	                                                                                    
	                                                                                    
	/* Write Data Generator                                                             
	 Data pattern is only a simple incrementing count from 0 for each burst  */         
	  always @(posedge M_AXI_ACLK)                                                      
	  begin                                                                             
	    if (M_AXI_ARESETN == 0 || init_txn_pulse == 1'b1)                                                         
	      axi_wdata <= 'b1;                                                             
	    //else if (wnext && axi_wlast)                                                  
	    //  axi_wdata <= 'b0;                                                           
	    else if (PROCESS_DONE_reg_negedge)                                                                 
	      axi_wdata <= GOODNESS_reg;                                                   
	    else                                                                            
	      axi_wdata <= axi_wdata;                                                       
	    end                                                                             


	//----------------------------
	//Write Response (B) Channel
	//----------------------------

	//The write response channel provides feedback that the write has committed
	//to memory. BREADY will occur when all of the data and the write address
	//has arrived and been accepted by the slave.

	//The write issuance (number of outstanding write addresses) is started by 
	//the Address Write transfer, and is completed by a BREADY/BRESP.

	//While negating BREADY will eventually throttle the AWREADY signal, 
	//it is best not to throttle the whole data channel this way.

	//The BRESP bit [1] is used indicate any errors from the interconnect or
	//slave for the entire write burst. This example will capture the error 
	//into the ERROR output. 

	  always @(posedge M_AXI_ACLK)                                     
	  begin                                                                 
	    if (M_AXI_ARESETN == 0 || init_txn_pulse == 1'b1 )                                            
	      begin                                                             
	        axi_bready <= 1'b0;                                             
	      end                                                               
	    // accept/acknowledge bresp with axi_bready by the master           
	    // when M_AXI_BVALID is asserted by slave                           
	    else if (M_AXI_BVALID && ~axi_bready)                               
	      begin                                                             
	        axi_bready <= 1'b1;                                             
	      end                                                               
	    // deassert after one clock cycle                                   
	    else if (axi_bready)                                                
	      begin                                                             
	        axi_bready <= 1'b0;                                             
	      end                                                               
	    // retain the previous value                                        
	    else                                                                
	      axi_bready <= axi_bready;                                         
	  end                                                                   
	                                                                        
	                                                                        
	//Flag any write response errors                                        
	  assign write_resp_error = axi_bready & M_AXI_BVALID & M_AXI_BRESP[1]; 


	//----------------------------
	//Read Address Channel
	//----------------------------

	//The Read Address Channel (AW) provides a similar function to the
	//Write Address channel- to provide the tranfer qualifiers for the burst.

	//In this example, the read address increments in the same
	//manner as the write address channel.

	  always @(posedge M_AXI_ACLK)                                 
	  begin                                                              
	                                                                     
	    if (M_AXI_ARESETN == 0 || init_txn_pulse == 1'b1 )                                         
	      begin                                                          
	        axi_arvalid <= 1'b0;                                         
	      end                                                            
	    // If previously not valid , start next transaction              
	    else if (~axi_arvalid && start_single_burst_read && !input_fifo_full)                
	      begin                                                          
	        axi_arvalid <= 1'b1;                                         
	      end                                                            
	    else if (M_AXI_ARREADY && axi_arvalid)                           
	      begin                                                          
	        axi_arvalid <= 1'b0;                                         
	      end                                                            
	    else                                                             
	      axi_arvalid <= axi_arvalid;                                    
	  end                                                                
	                                                                     
	                                                                     
	// Next address after ARREADY indicates previous address acceptance  
	  always @(posedge M_AXI_ACLK)                                       
	  begin                                                              
	    if (M_AXI_ARESETN == 0 || init_txn_pulse == 1'b1)                                          
	      begin                                                          
	        axi_araddr <= 'b0;                                           
	      end                                                            
	    else if (M_AXI_ARREADY && axi_arvalid)                           
	      begin                                                          
	        axi_araddr <= axi_araddr + read_burst_size_bytes;                 
	      end                                                            
	    else                                                             
	      axi_araddr <= axi_araddr;                                      
	  end                                                                


	//--------------------------------
	//Read Data (and Response) Channel
	//--------------------------------

	 // Forward movement occurs when the channel is valid and ready   
	  assign rnext = M_AXI_RVALID && axi_rready;                            
	                                                                        
	                                                                        
	// Burst length counter. Uses extra counter register bit to indicate    
	// terminal count to reduce decode logic                                
	  always @(posedge M_AXI_ACLK)                                          
	  begin                                                                 
	    if (M_AXI_ARESETN == 0 || init_txn_pulse == 1'b1 || start_single_burst_read)                  
	      begin                                                             
	        read_index <= 0;                                                
	      end                                                               
	    else if (rnext && (read_index != C_M_AXI_READ_BURST_LEN-1))              
	      begin                                                             
	        read_index <= read_index + 1;                                   
	      end                                                               
	    else                                                                
	      read_index <= read_index;                                         
	  end                                                                   
	                                                                        
	                                                                        
	/*                                                                      
	 The Read Data channel returns the results of the read request          
	                                                                        
	 In this example the data checker is always able to accept              
	 more data, so no need to throttle the RREADY signal                    
	 */                                                                     
	  always @(posedge M_AXI_ACLK)                                          
	  begin                                                                 
	    if (M_AXI_ARESETN == 0 || init_txn_pulse == 1'b1 )                  
	      begin                                                             
	        axi_rready <= 1'b0;                                             
	      end                                                               
	    // accept/acknowledge rdata/rresp with axi_rready by the master     
	    // when M_AXI_RVALID is asserted by slave                           
	    else if (M_AXI_RVALID)                       
	      begin     
			axi_rready <= (M_AXI_RLAST && axi_rready)? 1'b0:1'b1;                                
                                  
	      end                                        
	    // retain the previous value    
		else
			axi_rready <= axi_rready;             
	  end                                            
	                                                                        
	//Check received read data against data generator                       
	  always @(posedge M_AXI_ACLK)                                          
	  begin                                                                 
	    if (M_AXI_ARESETN == 0 || init_txn_pulse == 1'b1)                   
	      begin                                                             
	        read_mismatch <= 1'b0;                                          
	      end                                                               
	    //Only check data when RVALID is active                             
	    else if (rnext && (M_AXI_RDATA != expected_rdata))                  
	      begin                                                             
	        read_mismatch <= 1'b1;                                          
	      end                                                               
	    else                                                                
	      read_mismatch <= 1'b0;                                            
	  end                                                                   
	                                                                        
	//Flag any read response errors                                         
	  assign read_resp_error = axi_rready & M_AXI_RVALID & M_AXI_RRESP[1];  


	//----------------------------------------
	//Example design read check data generator
	//-----------------------------------------

	//Generate expected read data to check against actual read data

	  always @(posedge M_AXI_ACLK)                     
	  begin                                                  
		if (M_AXI_ARESETN == 0 || init_txn_pulse == 1'b1)// || M_AXI_RLAST)             
			expected_rdata <= 'b1;                            
		else if (M_AXI_RVALID && axi_rready)                  
			expected_rdata <= expected_rdata + 1;             
		else                                                  
			expected_rdata <= expected_rdata;                 
	  end                                                    


	//----------------------------------
	//Example design error register
	//----------------------------------

	//Register and hold any data mismatches, or read/write interface errors 

	  always @(posedge M_AXI_ACLK)                                 
	  begin                                                              
	    if (M_AXI_ARESETN == 0 || init_txn_pulse == 1'b1)                                          
	      begin                                                          
	        train_finish_reg <= 1'b0;                                           
	      end                                                            
	    else if (sample_count == TOTAL_TRAIN_SIZE)   
	      begin                                                          
	        train_finish_reg <= 1'b1;                                           
	      end                                                            
	    else                                                             
	      train_finish_reg <= train_finish_reg;                                        
	  end                                                                


	//--------------------------------
	//Example design throttling
	//--------------------------------

	// For maximum port throughput, this user example code will try to allow
	// each channel to run as independently and as quickly as possible.

	// However, there are times when the flow of data needs to be throtted by
	// the user application. This example application requires that data is
	// not read before it is written and that the write channels do not
	// advance beyond an arbitrary threshold (say to prevent an 
	// overrun of the current read address by the write address).

	// From AXI4 Specification, 13.13.1: "If a master requires ordering between 
	// read and write transactions, it must ensure that a response is received 
	// for the previous transaction before issuing the next transaction."

	// This example accomplishes this user application throttling through:
	// -Reads wait for writes to fully complete
	// -Address writes wait when not read + issued transaction counts pass 
	// a parameterized threshold
	// -Writes wait when a not read + active data burst count pass 
	// a parameterized threshold

	 // write_burst_counter counter keeps track with the number of burst transaction initiated            
	 // against the number of burst transactions the master needs to initiate                                   
	  always @(posedge M_AXI_ACLK)                                                                              
	  begin                                                                                                     
	    if (M_AXI_ARESETN == 0 || init_txn_pulse == 1'b1  || mst_exec_state == IDLE)                                                                                 
	      begin                                                                                                 
	        write_burst_counter <= 'b0;                                                                         
	      end                                                                                                   
	    else if (M_AXI_AWREADY && axi_awvalid)                                                                  
	      begin             
			 //write_burst_counter = 64,即突发传输64次完成写，每次写入64个地址，总共写入4096个地址 
			 //最多可写入2^(C_NO_BURSTS_REQ+1)个，即8K个地址                                                                                    
	        // if (write_burst_counter[C_NO_BURSTS_REQ] == 1'b0)                                                 
	        //   begin                                                                                             
	            write_burst_counter <= write_burst_counter + 1'b1;                                              
	            //write_burst_counter[C_NO_BURSTS_REQ] <= 1'b1;                                                 
	        //   end                                                                                               
	      end                                                                                                   
	    else                                                                                                    
	      write_burst_counter <= write_burst_counter;                                                           
	  end                                                                                                       
	                                                                                                            
	 // read_burst_counter counter keeps track with the number of burst transaction initiated                   
	 // against the number of burst transactions the master needs to initiate                                   
	  always @(posedge M_AXI_ACLK)                                                                              
	  begin                                                                                                     
	    if (M_AXI_ARESETN == 0 || init_txn_pulse == 1'b1 || mst_exec_state == IDLE)                                                                                 
	      begin                                                                                                 
	        read_burst_counter <= 'b0;                                                                          
	      end                                                                                                   
	    else if (M_AXI_ARREADY && axi_arvalid)                                                                  
	      begin                                                                                                 
	        if (read_burst_counter[C_NO_BURSTS_REQ] == 1'b0)                                                    
	          begin                                                                                             
	            read_burst_counter <= read_burst_counter + 1'b1;                                                
	            //read_burst_counter[C_NO_BURSTS_REQ] <= 1'b1;                                                  
	          end                                                                                               
	      end                                                                                                   
	    else                                                                                                    
	      read_burst_counter <= read_burst_counter;                                                             
	  end                                                                                                       
	                                                                                                            	                                                                                                                                                                            
	                                                                                                            
	  // burst_write_active signal is asserted when there is a burst write transaction                          
	  // is initiated by the assertion of start_single_burst_write. burst_write_active                          
	  // signal remains asserted until the burst write is accepted by the slave                                 
	  always @(posedge M_AXI_ACLK)                                                                              
	  begin                                                                                                     
	    if (M_AXI_ARESETN == 0 || init_txn_pulse == 1'b1)                                                                                 
	      burst_write_active <= 1'b0;                                                                                                                                                                          
	    //The burst_write_active is asserted when a write burst transaction is initiated                        
	    else if (start_single_burst_write)                                                                      
	      burst_write_active <= 1'b1;                                                                           
	    else if (M_AXI_BVALID && axi_bready)                                                                    
	      burst_write_active <= 1'b0;                                                                              
	  end                                                                                                       
	                                                                                                            
	 // Check for last write completion.                                                                        
	                                                                                                            
	 // This logic is to qualify the last write count with the final write                                      
	 // response. This demonstrates how to confirm that a write has been                                        
	 // committed.                                                                                              
	                                                                                                            
	  always @(posedge M_AXI_ACLK)                                                                              
	  begin                                                                                                     
	    if (M_AXI_ARESETN == 0 || init_txn_pulse == 1'b1)                                                                                 
	      writes_done <= 1'b0;                                                                                  
	                                                                                                            
	    //The writes_done should be associated with a bready response                                           
	    //else if (M_AXI_BVALID && axi_bready && (write_burst_counter == {(C_NO_BURSTS_REQ-1){1}}) && axi_wlast)
	    else if (M_AXI_BVALID && (write_burst_counter == ONE_SAMPLE_WRITE_BURST_COUNT) && axi_bready)  //待修改write_done拉高的条件                        
	      writes_done <= 1'b1;                                                                                  
	    else                                                                                                    
	      writes_done <= 1'b0;                                                                           
	    end                                                                                                     
	                                                                                                            
	  // burst_read_active signal is asserted when there is a burst write transaction                           
	  // is initiated by the assertion of start_single_burst_write. start_single_burst_read                     
	  // signal remains asserted until the burst read is accepted by the master                                 
	  always @(posedge M_AXI_ACLK)                                                                              
	  begin                                                                                                     
	    if (M_AXI_ARESETN == 0 || init_txn_pulse == 1'b1)                                                                                 
	      burst_read_active <= 1'b0;                                                                            
	                                                                                                            
	    //The burst_write_active is asserted when a write burst transaction is initiated                        
	    else if (start_single_burst_read)                                                                       
	      burst_read_active <= 1'b1;                                                                            
	    else if (M_AXI_RVALID && axi_rready && M_AXI_RLAST)                                                     
	      burst_read_active <= 0;                                                                               
	    end                                                                                                     
	                                                                                                            
	                                                                                                            
	 // Check for last read completion.                                                                         
	                                                                                                            
	 // This logic is to qualify the last read count with the final read                                        
	 // response. This demonstrates how to confirm that a read has been                                         
	 // committed.                                                                                              
	                                                                                                            
	  always @(posedge M_AXI_ACLK)                                                                              
	  begin                                                                                                     
	    if (M_AXI_ARESETN == 0 || init_txn_pulse == 1'b1)                                                                                 
	      reads_done <= 1'b0;                                                                                   
	                                                                                                            
	    //The reads_done should be associated with a rready response                                            
	    //else if (M_AXI_BVALID && axi_bready && (write_burst_counter == {(C_NO_BURSTS_REQ-1){1}}) && axi_wlast)
	    else if (M_AXI_RVALID && axi_rready && M_AXI_RLAST &&
	             (read_burst_counter == ONE_SAMPLE_READ_BURST_COUNT))
	      reads_done <= 1'b1;                                                                                   
	    else                                                                                                    
	      reads_done <= 1'b0;                                                                             
	    end                                                                                                     

	// Add user logic here
	//implement master command interface state machine                                       
//-----------------------------------------------------------------------
//--状态机第一段：同步时序描述状态转移
//-----------------------------------------------------------------------
	always@(posedge M_AXI_ACLK) begin
		if (M_AXI_ARESETN == 1'b0) begin
			mst_exec_state <= INIT;
		end
		else begin
			mst_exec_state <= mst_exec_state_next;
		end
	end
//-----------------------------------------------------------------------
//--状态机第二段：组合逻辑判断状态转移条件，描述状态转移规律以及输出
//-----------------------------------------------------------------------
	always @(*) begin
		case (mst_exec_state)
			INIT : begin
				mst_exec_state_next = (init_txn_pulse == 1'b1)? IDLE : INIT;
			end
			IDLE : begin
				mst_exec_state_next = (M_AXI_ARREADY)? READ_DATA : IDLE;
			end
			READ_DATA : begin
  			    mst_exec_state_next = (reads_done)? PROCESS_DATA : READ_DATA;
			end
			PROCESS_DATA : begin
			    mst_exec_state_next = (PROCESS_DONE_reg_negedge)? WRITE_DATA : PROCESS_DATA;
			end
			WRITE_DATA : begin
			    mst_exec_state_next = (writes_done)? DONE : WRITE_DATA;
			end
			DONE : begin
			    mst_exec_state_next = NEXT_SAMPLE;
			end
			NEXT_SAMPLE : begin
				mst_exec_state_next = (sample_count < (TOTAL_TRAIN_SIZE + TOTAL_TEST_SIZE))? IDLE : INIT;
			end
		endcase
	end

//-----------------------------------------------------------------------
//--状态机第三段：时序逻辑描述输出
//-----------------------------------------------------------------------
	// User logic ends
	always@(posedge M_AXI_ACLK) begin
		if(M_AXI_ARESETN == 1'b0) begin
			start_single_burst_write <= 1'b0;                                                                   
	        start_single_burst_read  <= 1'b0;                                                                                                                                           
	        TRAIN_FINISH_FLAG <= 1'b0;
			sample_count <= 'd0;
			IS_POS <= 1'b1;
			TRAIN_ENABLE_FLAG <= 1'b0;
			IS_TRAIN <= 1'b0;
			
		end 
		else
			case(mst_exec_state)					//根据当前状态进行输出
				INIT : begin
					sample_count <= 'd0;
					TRAIN_FINISH_FLAG <= 1'b0;
					TRAIN_ENABLE_FLAG <= train_enable_txn_pulse ? !TRAIN_ENABLE_FLAG : TRAIN_ENABLE_FLAG;
					IS_TRAIN <= TRAIN_ENABLE_FLAG;
					// IS_TRAIN <= 1'b0;
				end    
				IDLE : begin
				end
				READ_DATA : begin
				// This state is responsible to issue start_single_read pulse to                                
				// initiate a read transaction. Read transactions will be                                       
				// issued until burst_read_active signal is asserted.                                           
				// read controller  
					if(!reads_done)begin                                                                            																													
						if (~axi_arvalid && ~burst_read_active && ~start_single_burst_read && ~input_fifo_full)                         
						begin                                                                                     
							start_single_burst_read <= 1'b1;                                                        
						end                                                                                       
						else                                                                                         
						begin                                                                                      
							start_single_burst_read <= 1'b0; //Negate to generate a pulse                            
						end                                                                                        
					end       
				end
				PROCESS_DATA : begin
				end  
	          	WRITE_DATA : begin
					if(!writes_done) begin
						if (~axi_awvalid && ~start_single_burst_write && ~burst_write_active)                       
	                  begin                                                                                     
	                    start_single_burst_write <= 1'b1;                                                    
	                  end                                                                                       
	                else                                                                                        
	                  begin                                                                                     
	                    start_single_burst_write <= 1'b0; //Negate to generate a pulse                     
	                  end  
					end
				end                                                                                                                                                                                                                                                                                                          
	          DONE : begin                                                                                                                                                        
				  sample_count <= sample_count + 'd1;                                                                        
	            end
			  NEXT_SAMPLE: begin
			  		TRAIN_FINISH_FLAG <= train_finish_reg;
			  		IS_POS <= ~IS_POS;
					IS_TRAIN <= (sample_count < TOTAL_TRAIN_SIZE)? TRAIN_ENABLE_FLAG : 1'b0;
					// IS_TRAIN <= 1'b0;
			  end                                                                                             
	          default :                                                                                         
	            begin                                                                                                                                                       
	            end                                                                                             
	        endcase           
	end


	// fifo_rd_en读使能信号
	// 读使能信号，当fifo不为空，pts_ready有效，读使能信号为0，spike_data_vaild为0，finish为0时，读使能信号为1
	// 读出fifo数据直至排空
	always @(posedge SNN_CLK or negedge M_AXI_ARESETN) begin                                        
		if(!M_AXI_ARESETN)                               
			input_fifo_rd_en <= 0;						
		else if(!input_fifo_empty && pts_ready && !input_fifo_rd_en && !spike_data_vaild)                                
			input_fifo_rd_en <= 1;					
		else                      
			input_fifo_rd_en <= 0;               
	end
	// spike_data_vaild有效信号
	always @(posedge SNN_CLK or negedge M_AXI_ARESETN) begin                                        
		if(!M_AXI_ARESETN)                               
			spike_data_vaild <= 0;						
		else if(input_fifo_rd_en && !spike_data_vaild)                                
			spike_data_vaild <= 1;					
		else                      
			spike_data_vaild <= 0;               
	end
	always @(posedge SNN_CLK or negedge M_AXI_ARESETN) begin                                        
		if(!M_AXI_ARESETN)                               
			PROCESS_DONE_reg <= 2'b00;							
		else                             
			PROCESS_DONE_reg <= {PROCESS_DONE_reg[0], PROCESS_DONE};                           
	end
	always @(posedge SNN_CLK or negedge M_AXI_ARESETN) begin                                        
		if(!M_AXI_ARESETN)                               
			GOODNESS_reg <= 'd0;							
		else if(PROCESS_DONE)                             
			GOODNESS_reg <= GOODNESS;                
		else
			GOODNESS_reg <= GOODNESS_reg;			
	end
	 // AXI以小端的形式读取DDR数据，然而本项目DDR数据以大端存储，为此需要对输入数据按字节为单位进行倒序排列
	genvar i;
	genvar j;
	generate
		for (i = 0; i < 4; i = i + 1) begin : reverse_bytes
			for (j = 0; j < 8; j = j + 1) begin : reverse_bits
				assign M_AXI_RDATA_REVERSED[i*8+j] = M_AXI_RDATA[(4-i-1)*8 +j];
			end
			// assign M_AXI_RDATA_REVERSED[i] = M_AXI_RDATA[31 - i];
		end
	endgenerate

    axi_input_fifo                      axi_input_fifo_0(          
    .rst                                (!M_AXI_ARESETN            ),// input wire rst
    .wr_clk                             (M_AXI_ACLK                ),// input wire wr_clk
    .rd_clk                             (SNN_CLK                   ),// input wire rd_clk
    .din                                (M_AXI_RDATA_REVERSED     ),// input wire [31 : 0] din
    .wr_en                              (rnext & !input_fifo_full  ),// input wire wr_en
    .rd_en                              (input_fifo_rd_en          ),// input wire rd_en
    .dout                               (input_fifo_rd_out         ),// output wire [3 : 0] dout rd_en拉高后，延迟一周期dout才更新
    .full                               (input_fifo_full           ),// output wire full
    .empty                              (input_fifo_empty          ),// output wire empty
    .wr_rst_busy                        (                          ),// output wire wr_rst_busy
    .rd_rst_busy                        (                          ) // output wire rd_rst_busy
    );

    parallel_to_serial#(
    .DATA_WIDTH                         (4                         ),
    .CNT_MAX                            (DATA_SIZE                 )
    )
    u_parallel_to_serial(
    .CLK                                (SNN_CLK                   ),
    .rst_n                              (M_AXI_ARESETN             ),
    .din_parallel                       (input_fifo_rd_out         ),
    .din_valid                          (spike_data_vaild          ),
    .AER_IN_ACK                         (AER_IN_ACK                ),
    .pts_ready                          (pts_ready                 ),
    .AER_IN_ADDR                        (AER_IN_ADDR               ),
    .AER_IN_REQ                         (AER_IN_REQ                ),
    .finish                             (finish                    ) 
    );

	endmodule
