Mogreach/SNN_FF-STDP_v1/(commit log)

2026-09-14 新增测试tb
2026-09-14 整理非文档代码与仿真环境
2026-09-14 移除SPI并集中仿真RAM初始化
2026-09-14 参数化神经元计数并清理控制器冗余状态
2026-09-14 清理死逻辑并统一仿真与文档配置
    - 移除 SPI 遗留的 NEUR_STATE 链路、无引用的 byte 地址/阈值中间量与 goodness 旧加法中间量。
    - NET_PATH 改指仓库内 hardware_sim/MNIST_91.pth（相对仓库根目录）。
    - run_axi_snn.sh 产物与 TB 的 VCD 输出统一到 build_axi_test/，并同步 .gitignore。
    - 刷新各 README 与设计文档：删除已不存在的多层变体/SPI 说明，补全四个 TB 数据路径参数与 Icarus 回归入口。
2026-09-14 加入存储器 FPGA/仿真双模式并锚定脚本路径
    - 用 SNN_RAM_SIM 宏区分存储实现：默认 FPGA 分支实例化 sram_synaptic BRAM IP，
    仿真分支用行为模型；sram_synaptic.v 整体由 ifdef 包住，避免与 IP 重复定义。
    - 神经元状态在 FPGA 模式下改为模块内可综合 initial $readmemh，路径由
    SNN_PRE/POST_NEUR_STATE_FILE 在综合时传入，缺失则编译期报错。
    - 生成脚本以 hardware_sim_config.py 的 REPO_ROOT 锚定路径，不再依赖工作目录；
    修正 gen_sigmoid.py 的 ROM 输出路径与 test_debug.py 的 checkpoint 路径。
    - 同步更新 sram/synaptic_core README、仿真 README 与主设计文档。
    [gen_data_flow.py, gen_model_weight_coe.py, gen_neuron_state.py, gen_sigmoid.py, hardware_sim_config.py, sram_post_neuron.v, sram_pre_neuron.v, sram_synaptic.v]
2026-09-15 硬件稳定综合仿真版本
2026-09-15 软件依赖稳定版本
2026-09-15 README更新
2026-09-15 iverilog bash更新
2026-09-15 主文档人工修订更新
2026-10-22 完善加速器文档与仿真启动脚本
2026-10-22 更新.gitignore，移除Release目录并添加/thesis材料
2026-10-22 Add design images and documentation for FF-STDP accelerator project
    - Added multiple PNG images related to the FF-STDP accelerator design, including historical diagrams, Vivado screenshots, waveforms, and timing analysis images.
    - Introduced a README.md file to provide context and guidelines for the directory structure and image usage.
    - Ensured all images are stored in the designated assets folder with appropriate naming conventions for traceability.
    - Created a main README.md file in the assets directory to outline the organization of document resources.
