Mogreach/SNN_FF-STDP_v1/(notices)

Notices in the files:
user/src/key_debounce.v:
Copyright(C) ÕýµãÔ­×Ó 2023-2033
All rights reserved
